CasualCanadian/jareds/Schedule/J.A.R.E.D.S Timeline.pdf

J.A.R.E.D.S Timeline | May 14, 2021 http://
Project manager | Gabriel Carey
Project dates | May 17, 2021 - Jun. 21, 2021
Completion | 0%
Tasks | 14
Resources | 1

Scheduled tasks for J.A.R.E.D.S.

Name | Begin date | End date
3D Printing Design/3D Print any necessary parts for functionality/ergonomics/aesthetics. | 2021-05-17 | 2021-06-04
Gun Hardware Modify Nerf gun, implement new hardware components and schematic. | 2021-05-17 | 2021-05-21
Gun Hardware Complete | 2021-05-24 | 2021-05-24
Structure Gun Firmware Program Arduino for basic functionality, debug system. Begin structuing code for later. | 2021-05-20 | 2021-05-25
Frame Construct frame, test servos. | 2021-05-24 | 2021-05-28
Structure Frame Firmware Program Arduino for basic functionality, debug system. Begin structuing code for later. Tune servos for movement. | 2021-05-26 | 2021-06-01
Frame Complete | 2021-05-31 | 2021-05-31
Gun Firmware Finish coding firmware for Nerf gun. Add functionality to all components and debug code. | 2021-06-02 | 2021-06-04
Gun Firmware Complete | 2021-06-07 | 2021-06-07
Develop Bluetooth Application Develop PC Bluetooth application for remote control of the sentry gun. | 2021-06-07 | 2021-06-11
Software Develop auto-targeting software on Raspberry Pi using Python. Implement serial communication between Raspberry Pi and Arduino. Program interface for Arduino to communicate with Raspberry Pi, receive data and control servos. | 2021-06-07 | 2021-06-16
Complete Software | 2021-06-17 | 2021-06-17
Testing/Debugging Final testing/debugging for reliable operation. | 2021-06-14 | 2021-06-18
Complete Project | 2021-06-21 | 2021-06-21
J.A.R.E.D.S Timeline | May 14, 2021
Tasks | 2

Name | Default role
Gabriel Carey | project manager

# Resources

3

# Gantt Chart

4

Structure Gun Firmware | 2021-05-20 | 2021-05-25
Frame | 2021-05-24 | 2021-05-28
Structure Frame Firmware | 2021-05-26 | 2021-06-01
Frame Complete | 2021-05-31 | 2021-05-31
Gun Firmware | 2021-06-02 | 2021-06-04
Gun Firmware Complete | 2021-06-07 | 2021-06-07
Develop Bluetooth Application 2021-06-07 | 2021-06-11
Software | 2021-06-07 | 2021-06-16
Complete Software | 2021-06-17 | 2021-06-17
Testing/Debugging | 2021-06-14 | 2021-06-18
Complete Project | 2021-06-21 | 2021-06-21

# Resources Chart

5
