CasualCanadian/jareds/Schedule/J.A.R.E.D.S Timeline.png

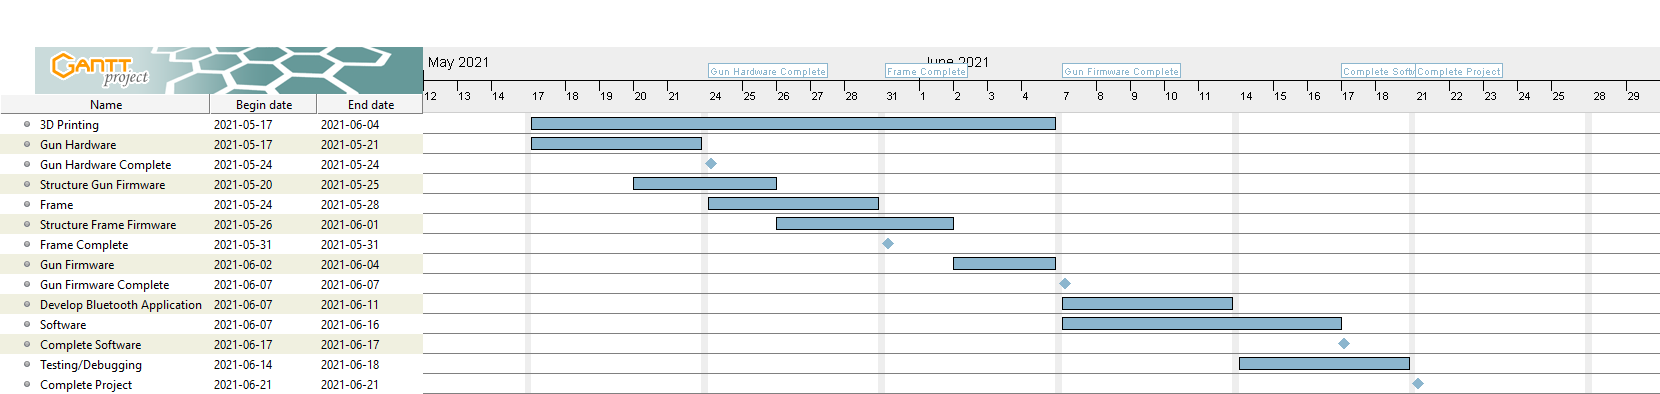
Schedule/J.A.R.E.D.S Timeline.png
