CasualCanadian/jareds/Schematics/J.A.R.E.D.S_Gun_schem.png

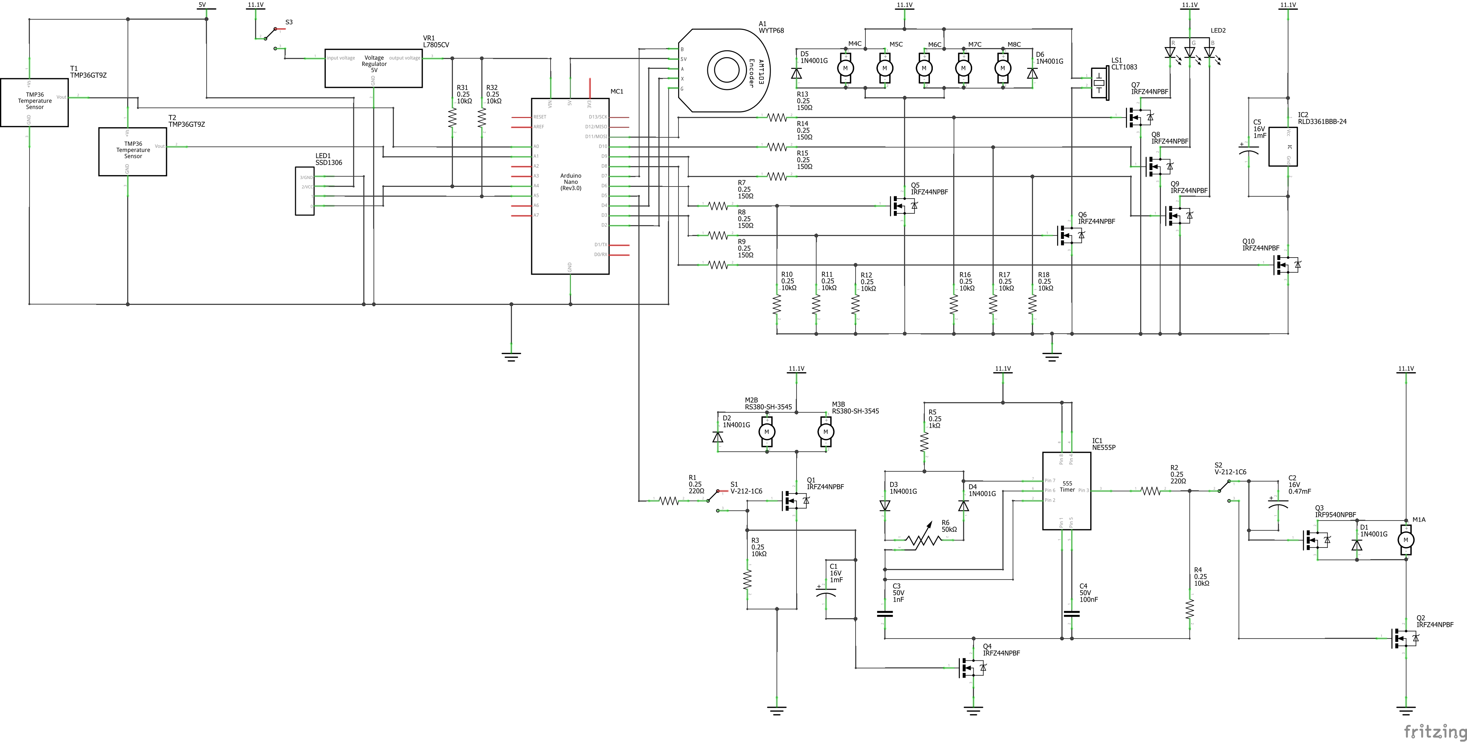
Schematics/J.A.R.E.D.S_Gun_schem.png
