CasualCanadian/jareds/3D Models/Rear_Assembly.stl

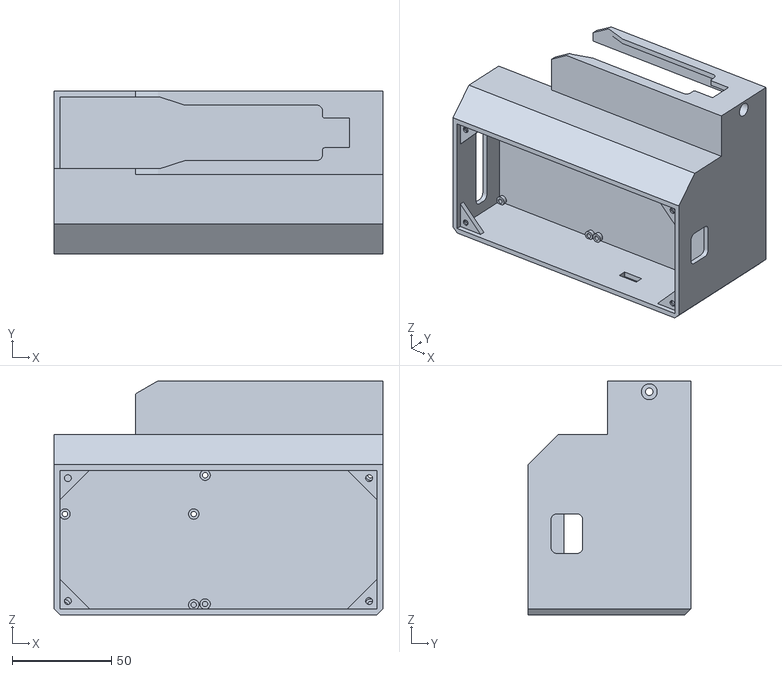
[picture p13: CAD file, 2023-03-03]
3D Models/Rear_Assembly.stl
166.0 x 82.0 x 118.0
