CasualCanadian/jareds/3D Models/Bearing Frame.stl

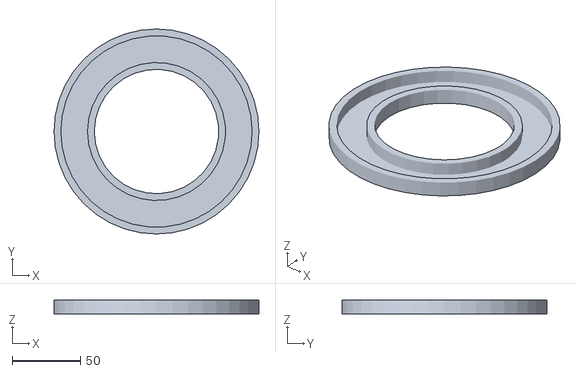
[picture p14: CAD file, 2023-03-03]
3D Models/Bearing Frame.stl
150.0 x 150.0 x 10.0
