CasualCanadian/jareds/3D Models/Frame Model v1/Base_BottomPlate.stl

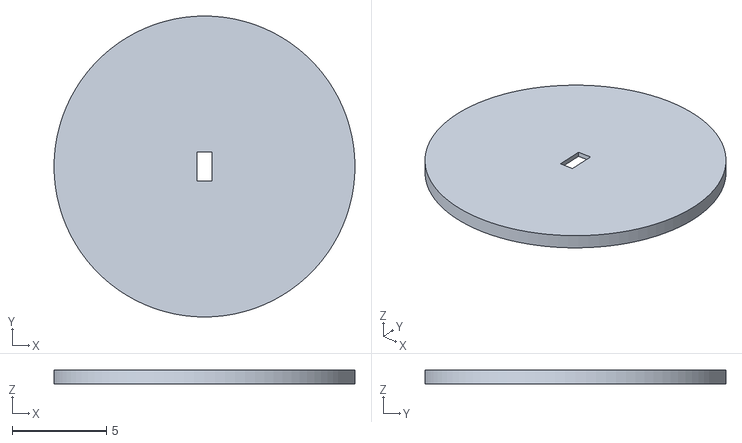
[picture p15: CAD file, 2023-03-03]
3D Models/Frame Model v1/Base_BottomPlate.stl
16.0 x 16.0 x 0.75
