CasualCanadian/jareds/3D Models/Frame Model v1/Arm_Upper.stl

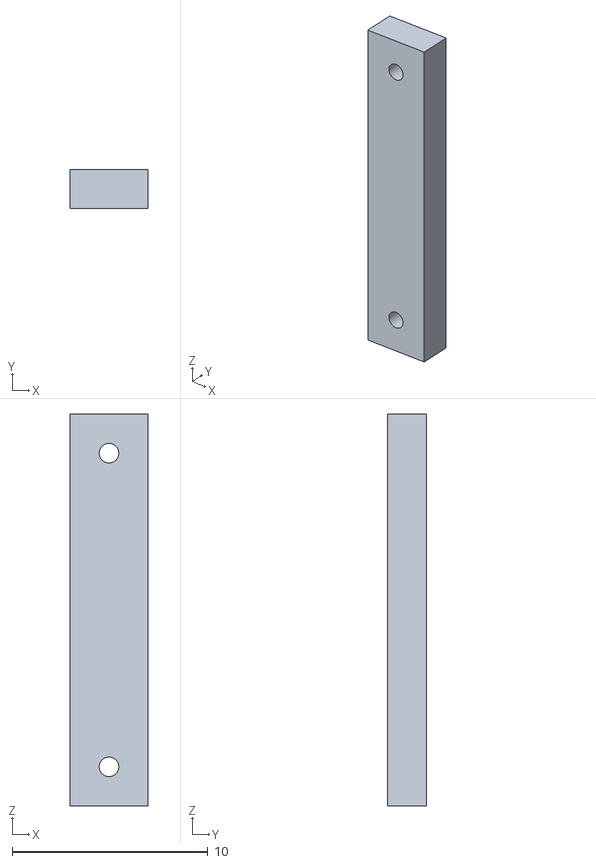
[picture p16: CAD file, 2023-03-03]
3D Models/Frame Model v1/Arm_Upper.stl
4.00 x 2.00 x 20.0
