CasualCanadian/jareds/3D Models/Frame Model v1/Base_Leg.stl

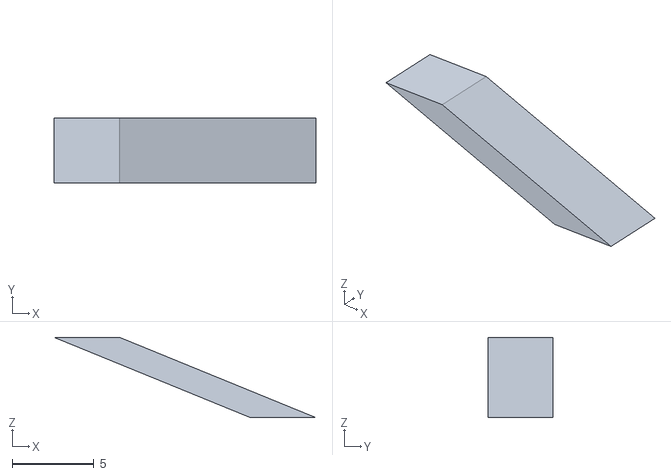
[picture p17: CAD file, 2023-03-03]
3D Models/Frame Model v1/Base_Leg.stl
16.0 x 4.00 x 4.91
