CasualCanadian/jareds/3D Models/Edge Bearing.stl

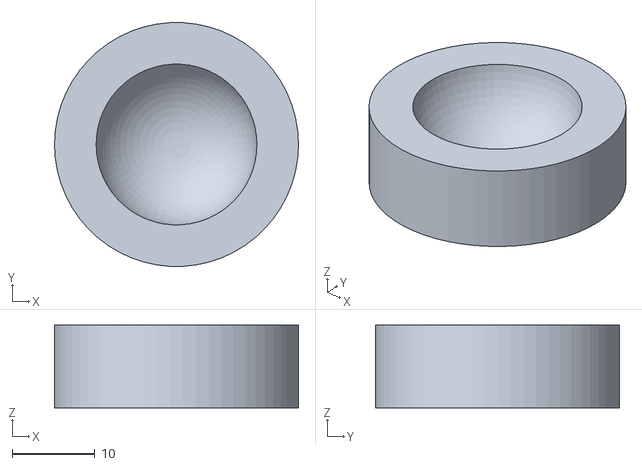
[picture p18: CAD file, 2023-03-03]
3D Models/Edge Bearing.stl
29.5 x 29.5 x 10.0
