CasualCanadian/jareds/3D Models/Frame Model v1/Dowel 2.stl

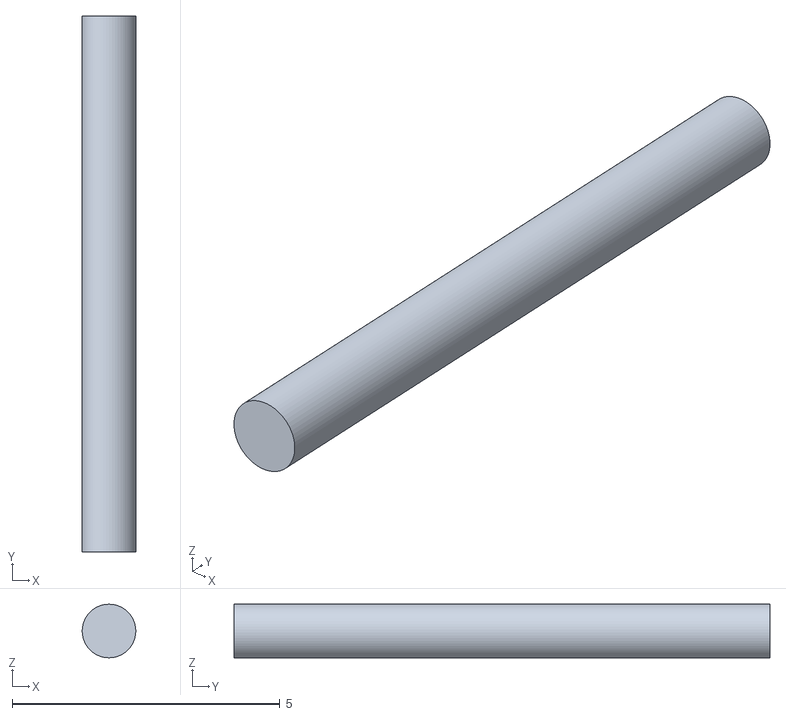
[picture p19: CAD file, 2023-03-03]
3D Models/Frame Model v1/Dowel 2.stl
0.999 x 10.0 x 1
