CasualCanadian/jareds/3D Models/Frame Model v1/Arm_ConnectorLeft.stl

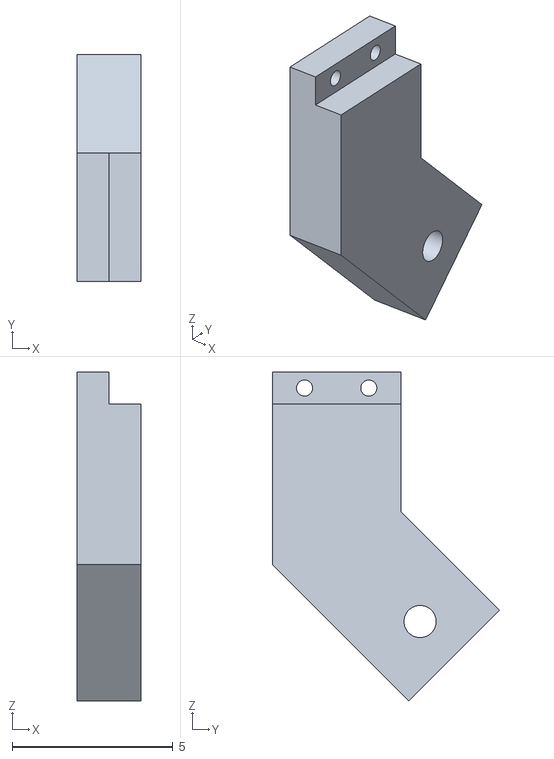
[picture p20: CAD file, 2023-03-03]
3D Models/Frame Model v1/Arm_ConnectorLeft.stl
2.00 x 7.07 x 10.2
