CasualCanadian/jareds/3D Models/Frame Model v1/Base_TopPlate.stl

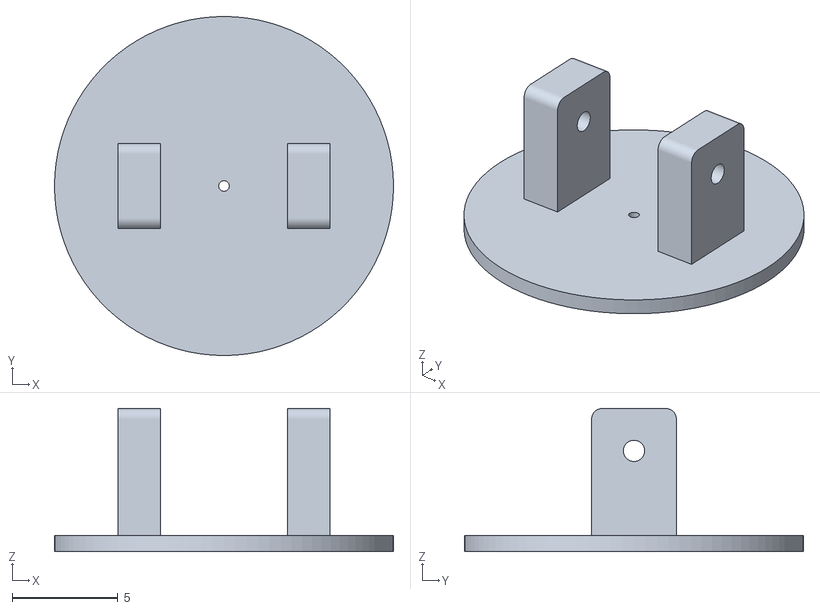
[picture p21: CAD file, 2023-03-03]
3D Models/Frame Model v1/Base_TopPlate.stl
16.0 x 16.0 x 6.75
