CasualCanadian/jareds/3D Models/Handle_Left.stl

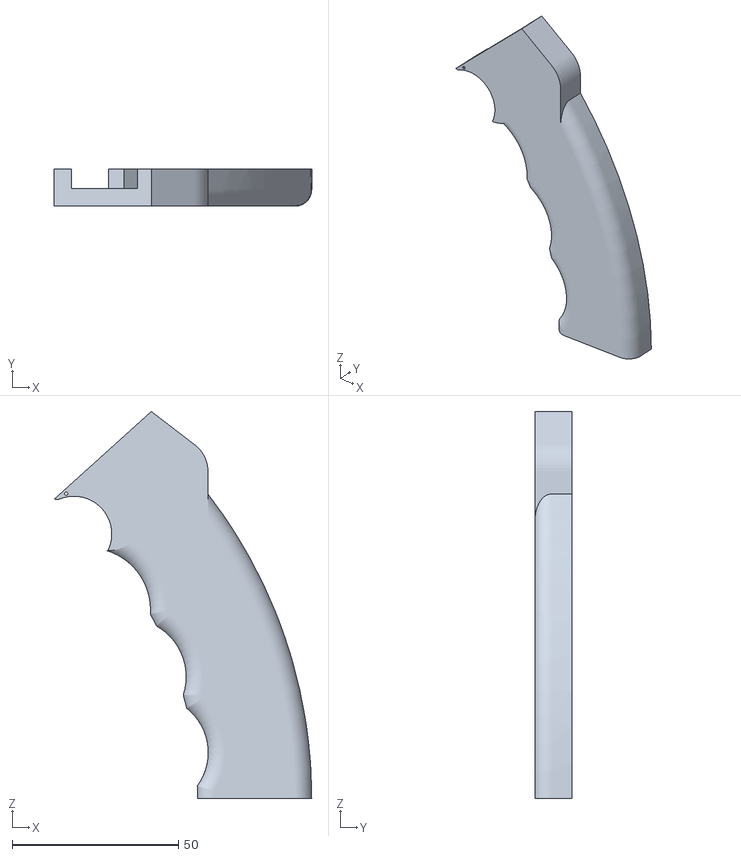
[picture p22: CAD file, 2023-03-03]
3D Models/Handle_Left.stl
77.5 x 11.3 x 116.4
