CasualCanadian/jareds/3D Models/Frame Model v1/Dowel 1.stl

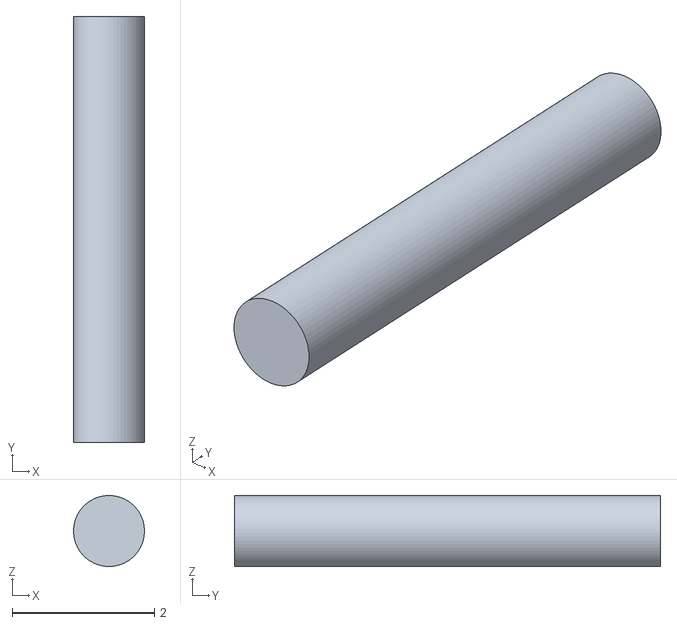
[picture p23: CAD file, 2023-03-03]
3D Models/Frame Model v1/Dowel 1.stl
0.999 x 6.00 x 1
