CasualCanadian/jareds/3D Models/Bearing.stl

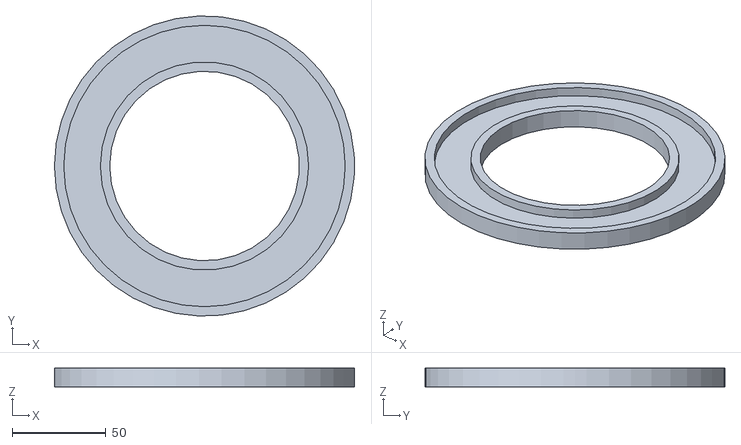
[picture p24: CAD file, 2023-03-03]
3D Models/Bearing.stl
160.0 x 159.9 x 10.0
