CasualCanadian/jareds/3D Models/Frame Model v1/Base_Leg 2.stl

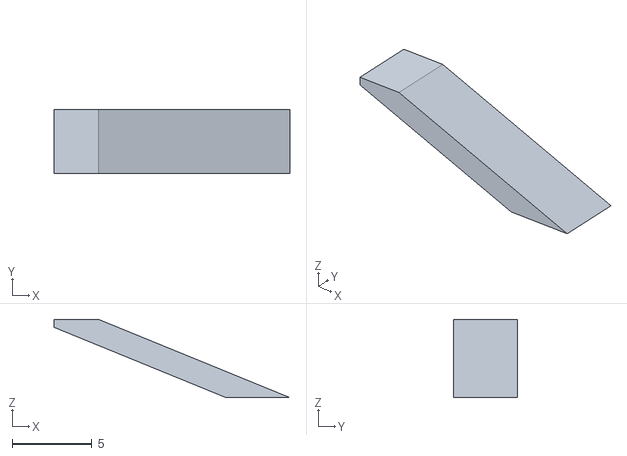
[picture p25: CAD file, 2023-03-03]
3D Models/Frame Model v1/Base_Leg 2.stl
14.8 x 4.00 x 4.91
