CasualCanadian/jareds/3D Models/Frame Model v1/Base_Adapter.stl

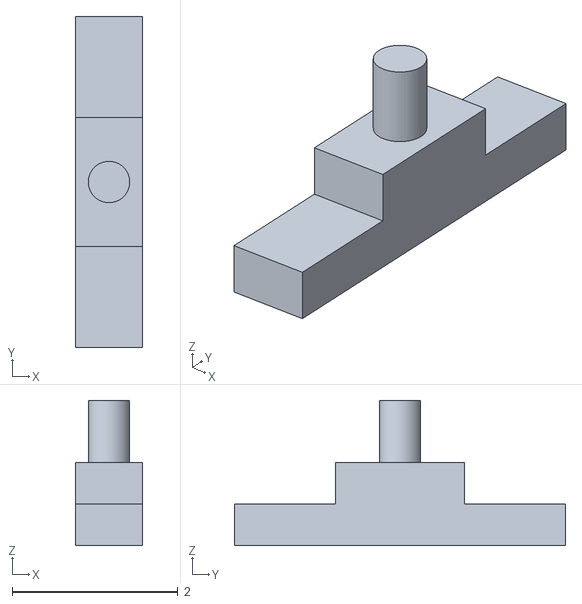
[picture p26: CAD file, 2023-03-03]
3D Models/Frame Model v1/Base_Adapter.stl
0.81 x 4.00 x 1.75
