CasualCanadian/jareds/3D Models/Motor Housing.stl

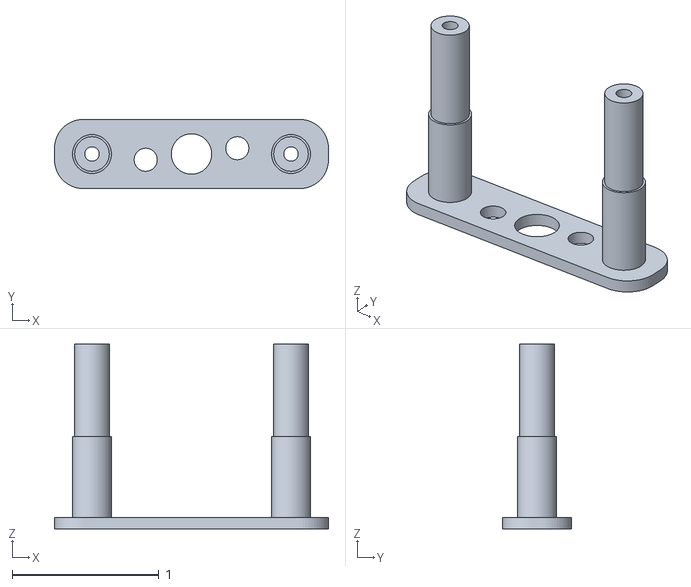
[picture p27: CAD file, 2023-03-03]
3D Models/Motor Housing.stl
1.87 x 0.472 x 1.26
