CasualCanadian/jareds/3D Models/BearingFramev2.stl

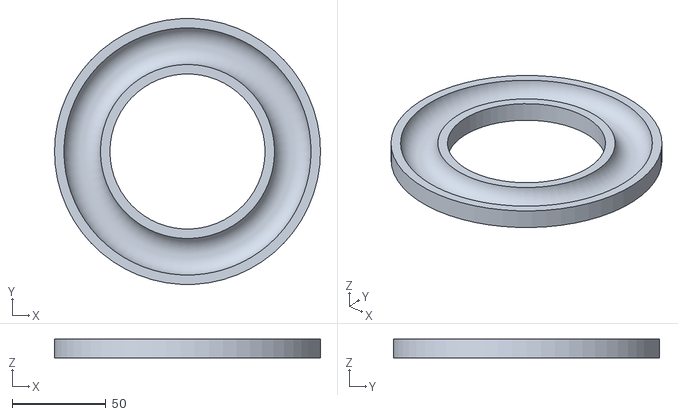
[picture p28: CAD file, 2023-03-03]
3D Models/BearingFramev2.stl
141.5 x 141.3 x 10.0
