CasualCanadian/jareds/3D Models/Rear Mount.stl

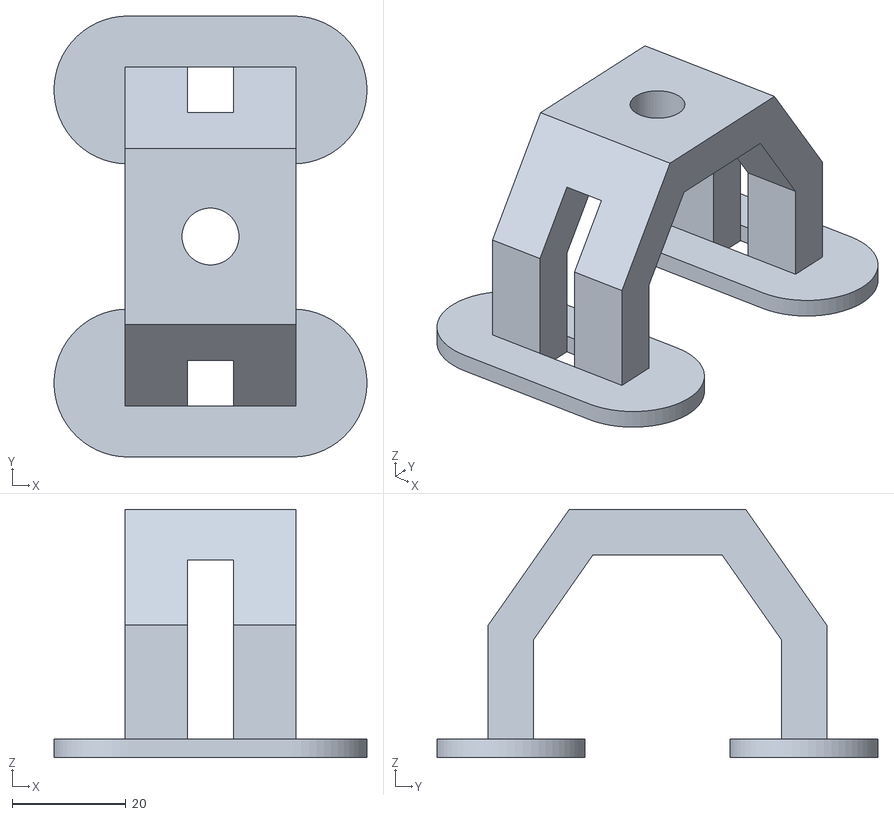
[picture p30: CAD file, 2023-03-03]
3D Models/Rear Mount.stl
55.0 x 77.5 x 43.7
