CasualCanadian/jareds/3D Models/J.A.R.E.D.S Name Plate.stl

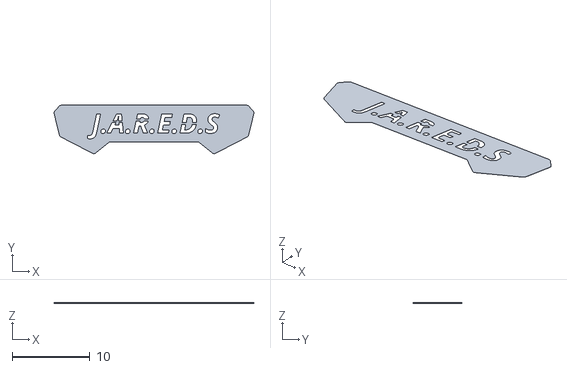
[picture p31: CAD file, 2023-03-03]
3D Models/J.A.R.E.D.S Name Plate.stl
25.7 x 6.24 x 0.08
