CasualCanadian/jareds/3D Models/Front Mount.stl

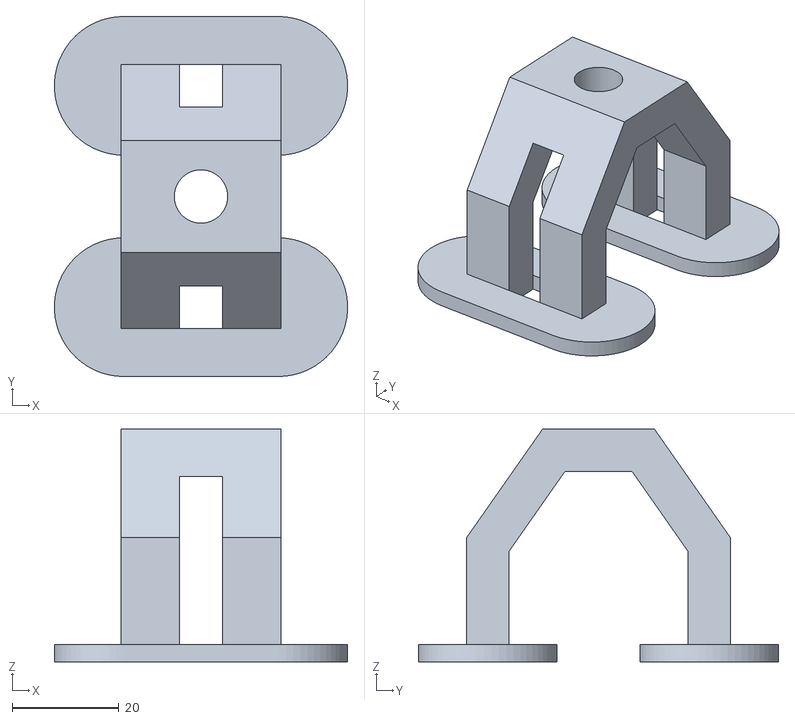
[picture p32: CAD file, 2023-03-03]
3D Models/Front Mount.stl
55.0 x 67.5 x 43.7
