CasualCanadian/jareds/3D Models/Trigger.stl

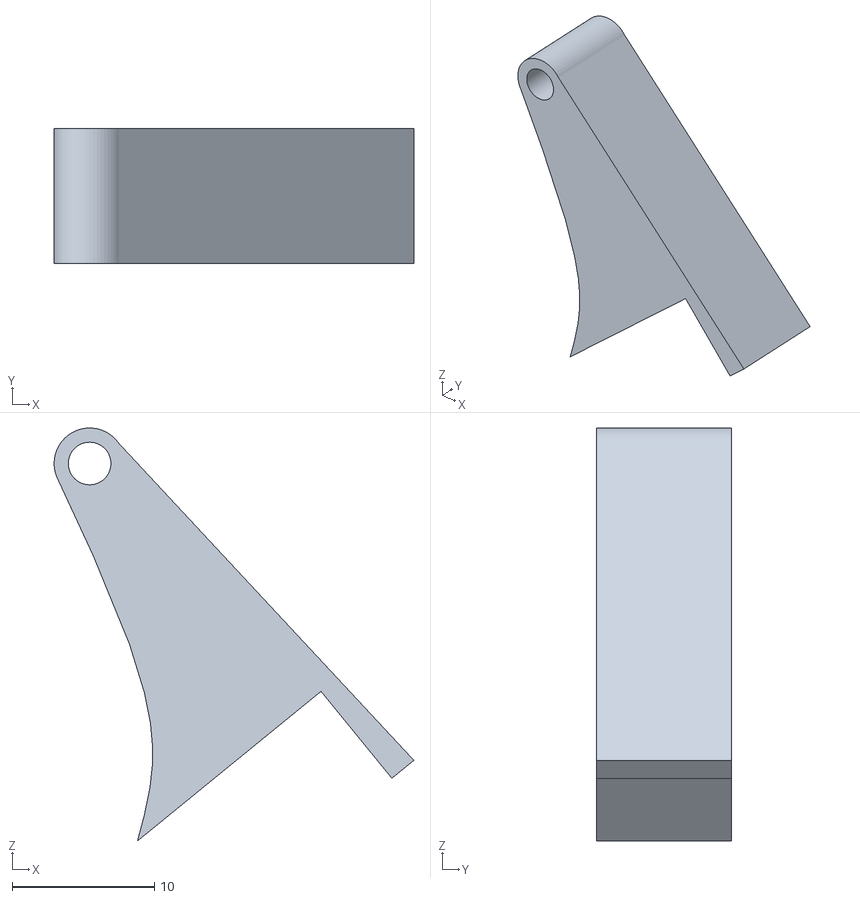
[picture p33: CAD file, 2023-03-03]
3D Models/Trigger.stl
25.3 x 9.50 x 29.1
