CasualCanadian/jareds/3D Models/Trigger_LongLever.stl

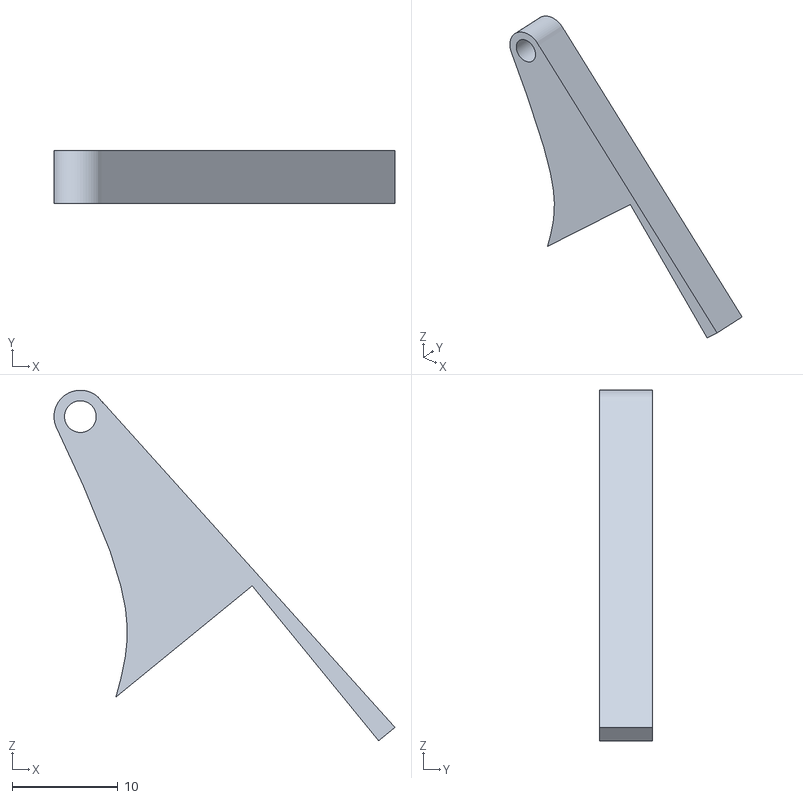
[picture p34: CAD file, 2023-03-03]
3D Models/Trigger_LongLever.stl
32.3 x 5.00 x 33.2
