CasualCanadian/jareds/3D Models/J.A.R.E.D.S_Stencilv2.stl

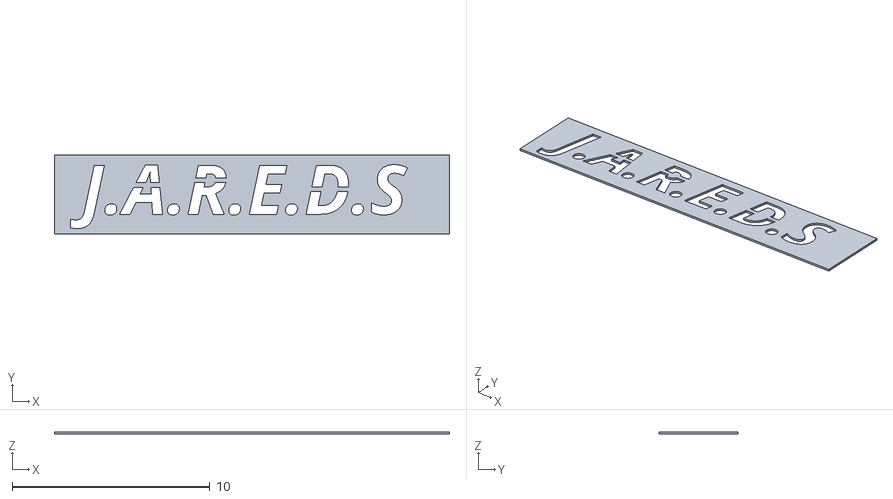
[picture p35: CAD file, 2023-03-03]
3D Models/J.A.R.E.D.S_Stencilv2.stl
20.0 x 4.00 x 0.1
