CasualCanadian/jareds/3D Models/JAREDS Template.stl

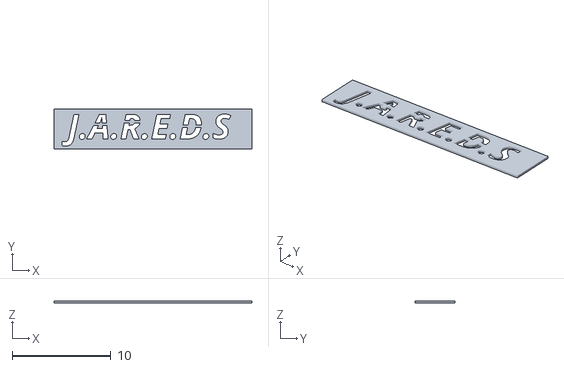
[picture p36: CAD file, 2023-03-03]
3D Models/JAREDS Template.stl
20.0 x 4.00 x 0.2
