CasualCanadian/jareds/3D Models/Bearing_Top.stl

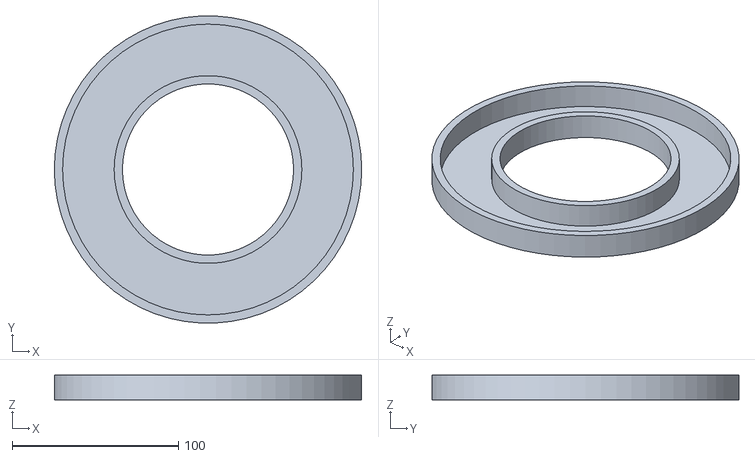
[picture p37: CAD file, 2023-03-03]
3D Models/Bearing_Top.stl
185.0 x 184.7 x 15.0
