CasualCanadian/jareds/3D Models/Handle_Right - Part 3.stl

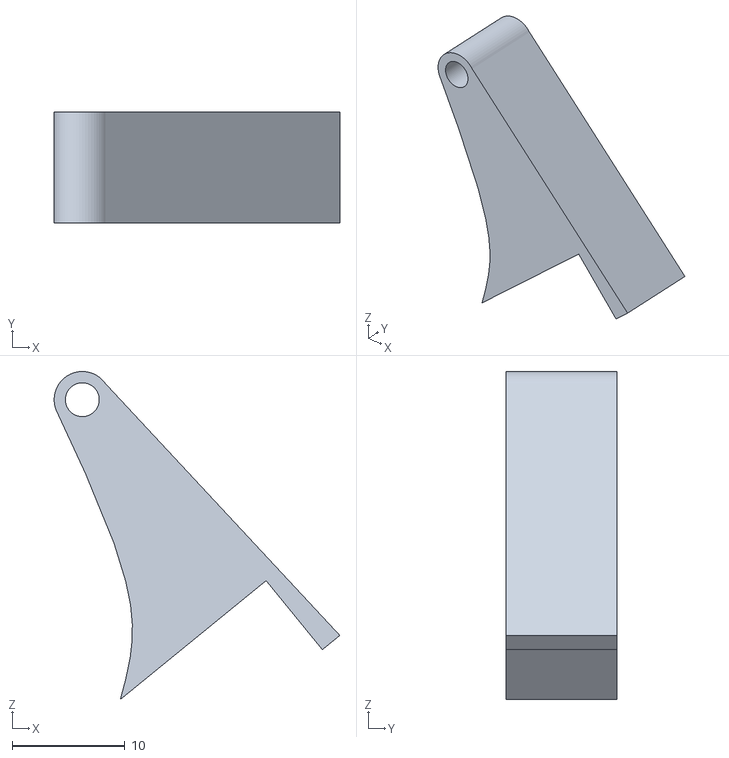
[picture p38: CAD file, 2023-03-03]
3D Models/Handle_Right - Part 3.stl
25.3 x 9.80 x 29.1
