CasualCanadian/jareds/3D Models/Grip_Right.stl

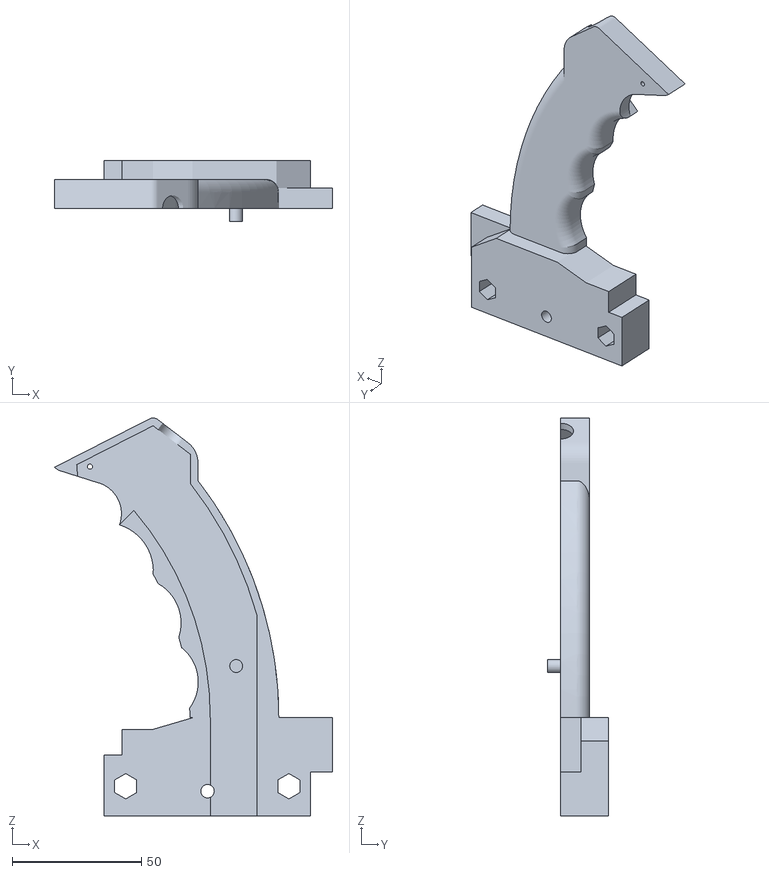
[picture p39: CAD file, 2023-03-03]
3D Models/Grip_Right.stl
107.7 x 23.5 x 153.9
