CasualCanadian/jareds/3D Models/Camera_FrontMount.stl

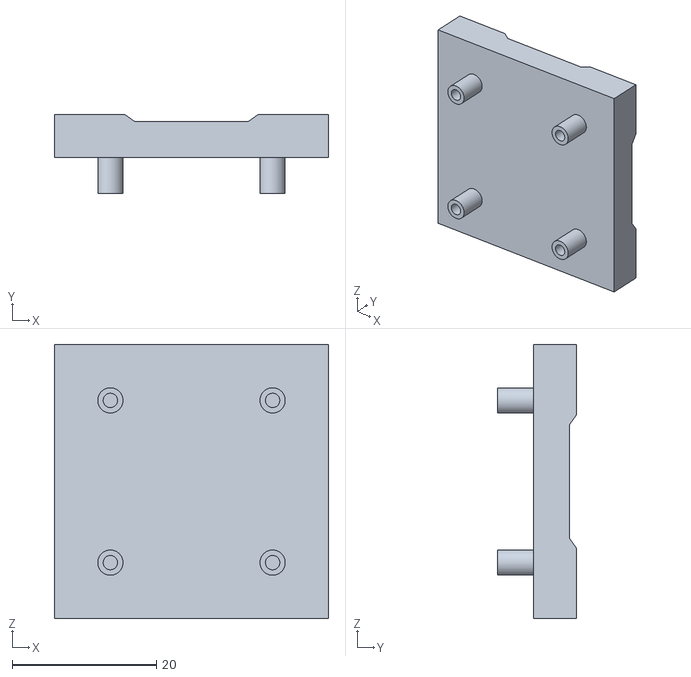
[picture p40: CAD file, 2023-03-03]
3D Models/Camera_FrontMount.stl
38.0 x 11.0 x 38.0
