CasualCanadian/jareds/3D Models/Arm_BasePlate.stl

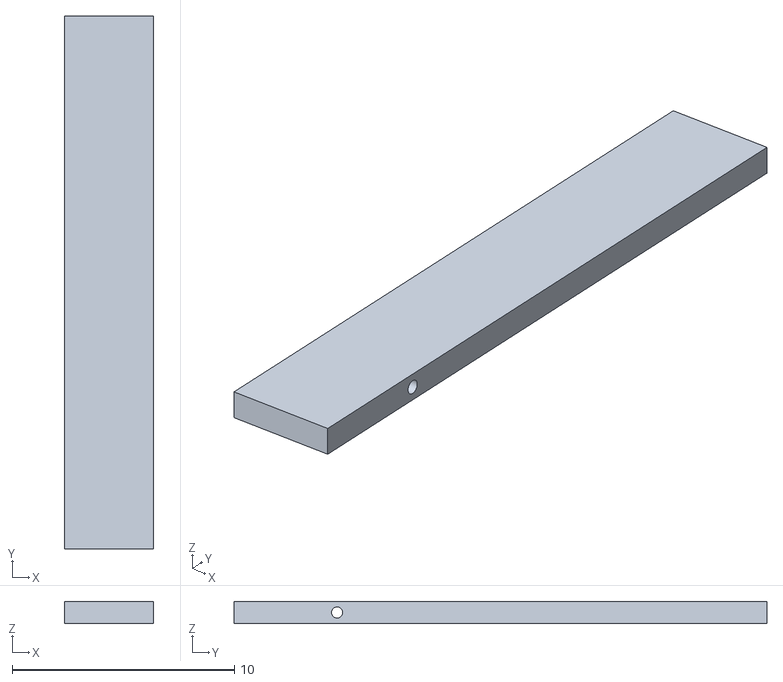
[picture p41: CAD file, 2023-03-03]
3D Models/Arm_BasePlate.stl
4.00 x 24.0 x 1.00
