CasualCanadian/jareds/3D Models/Gun Mount.stl

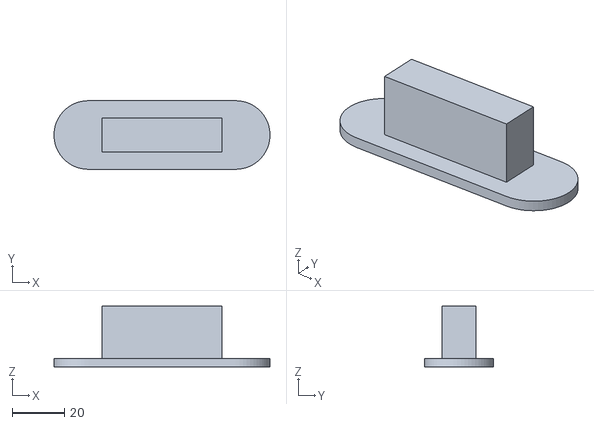
[picture p42: CAD file, 2023-03-03]
3D Models/Gun Mount.stl
82.8 x 26.3 x 23.3
