CasualCanadian/jareds/3D Models/Voltmeter_Spacer.stl

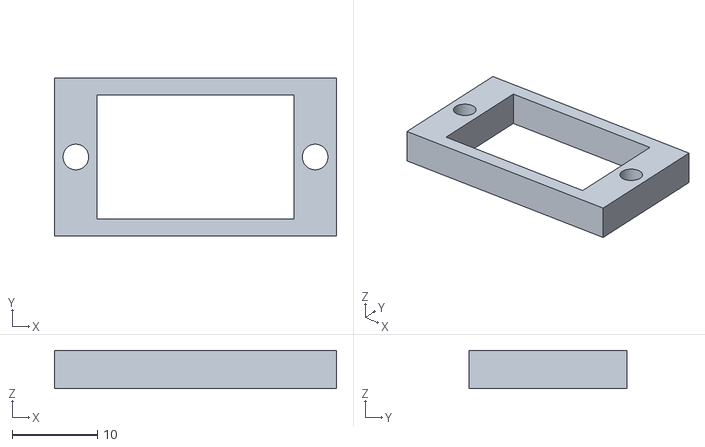
[picture p43: CAD file, 2023-03-03]
3D Models/Voltmeter_Spacer.stl
33.0 x 18.5 x 4.50
