CasualCanadian/jareds/3D Models/Bottom Adapter.stl

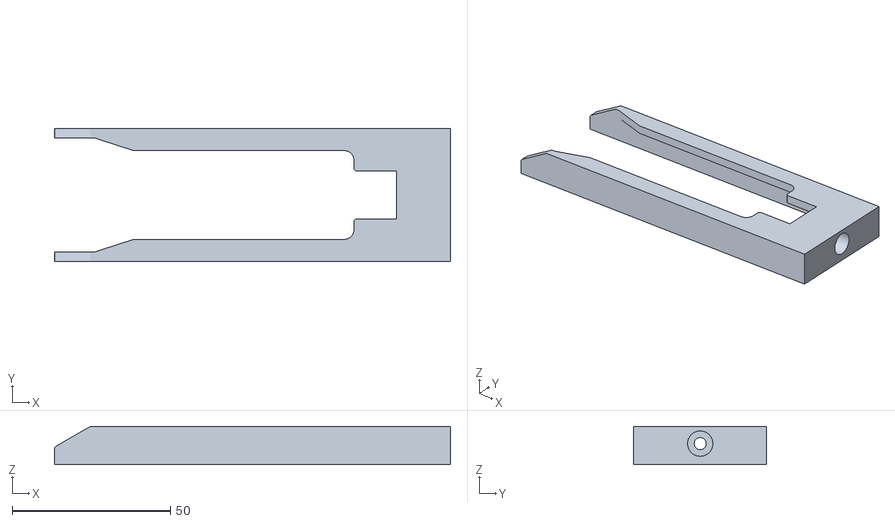
[picture p44: CAD file, 2023-03-03]
3D Models/Bottom Adapter.stl
125.0 x 42.0 x 12.0
