CasualCanadian/jareds/3D Models/J.A.R.E.D.S Handle Adapter.stl

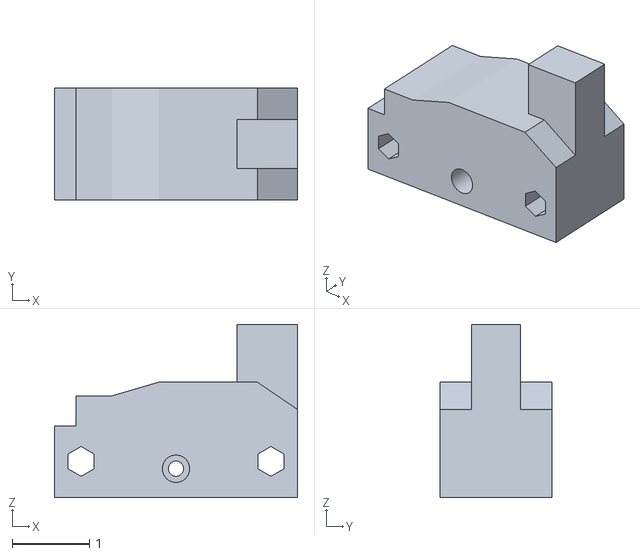
[picture p45: CAD file, 2023-03-03]
3D Models/J.A.R.E.D.S Handle Adapter.stl
3.15 x 1.46 x 2.24
