CasualCanadian/jareds/3D Models/Part Studio 1.stl

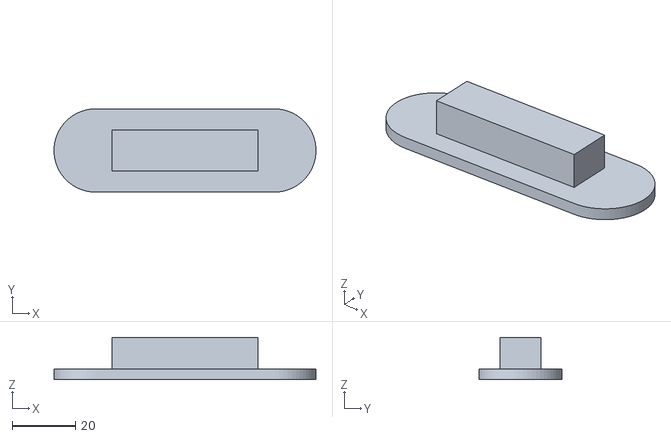
[picture p46: CAD file, 2023-03-03]
3D Models/Part Studio 1.stl
82.8 x 26.3 x 13.3
