CasualCanadian/jareds/3D Models/Rev_Switch.stl

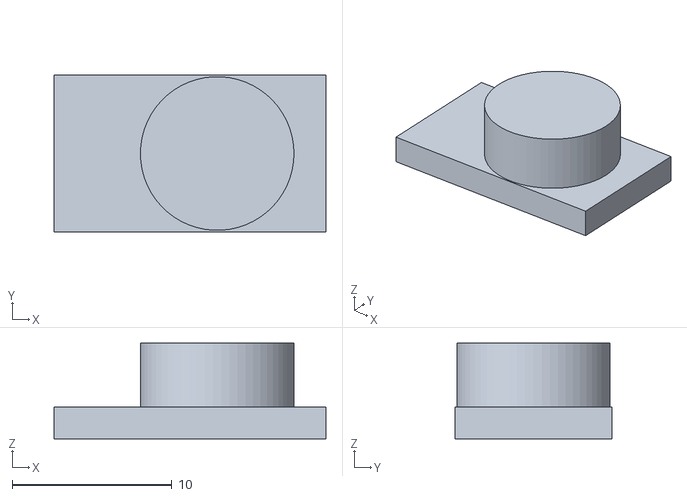
[picture p47: CAD file, 2023-03-03]
3D Models/Rev_Switch.stl
17.0 x 9.80 x 6.00
