CasualCanadian/jareds/3D Models/v1.stl

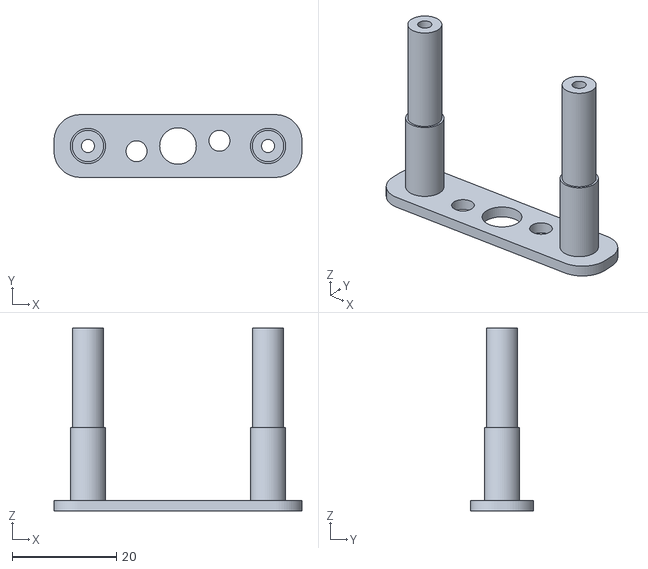
[picture p48: CAD file, 2023-03-03]
3D Models/v1.stl
47.5 x 12.0 x 35.0
