CasualCanadian/jareds/3D Models/Grip_Trigger.stl

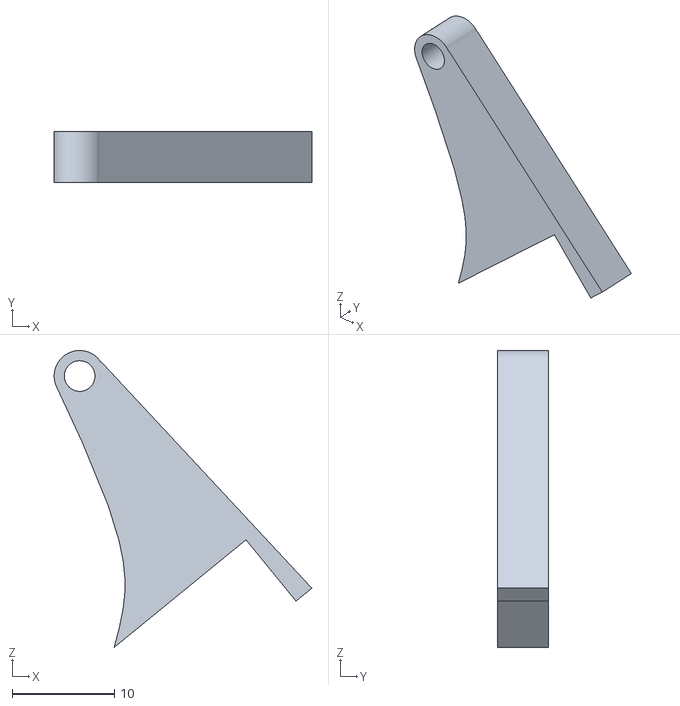
[picture p49: CAD file, 2023-03-03]
3D Models/Grip_Trigger.stl
25.2 x 5.00 x 29.1
