CasualCanadian/jareds/3D Models/gm.stl

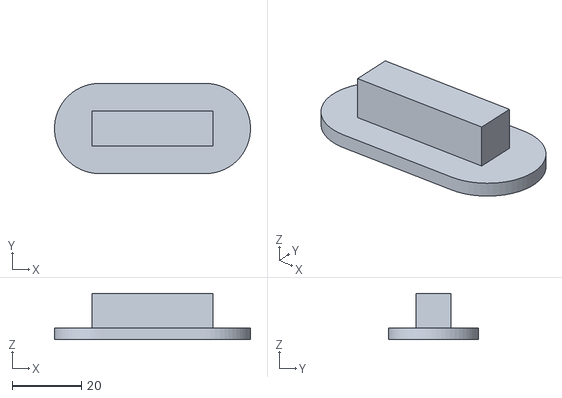
[picture p50: CAD file, 2023-03-03]
3D Models/gm.stl
56.5 x 26.0 x 13.3
