CasualCanadian/jareds/3D Models/J.A.R.E.D.S Template v2.stl

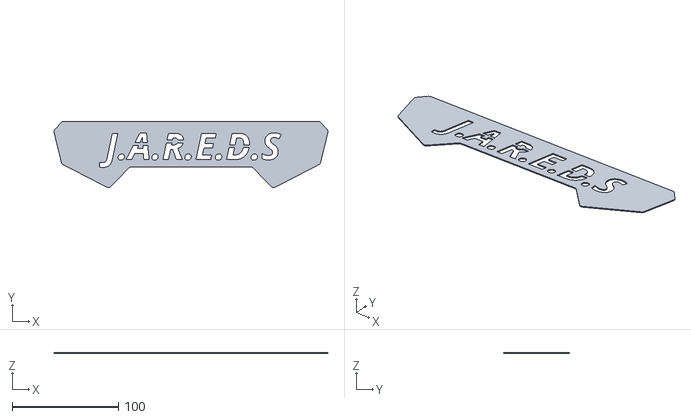
[picture p51: CAD file, 2023-03-03]
3D Models/J.A.R.E.D.S Template v2.stl
257.4 x 62.3 x 0.8
