CasualCanadian/jareds/3D Models/J.A.R.E.D.S Handle Adapter v2.stl

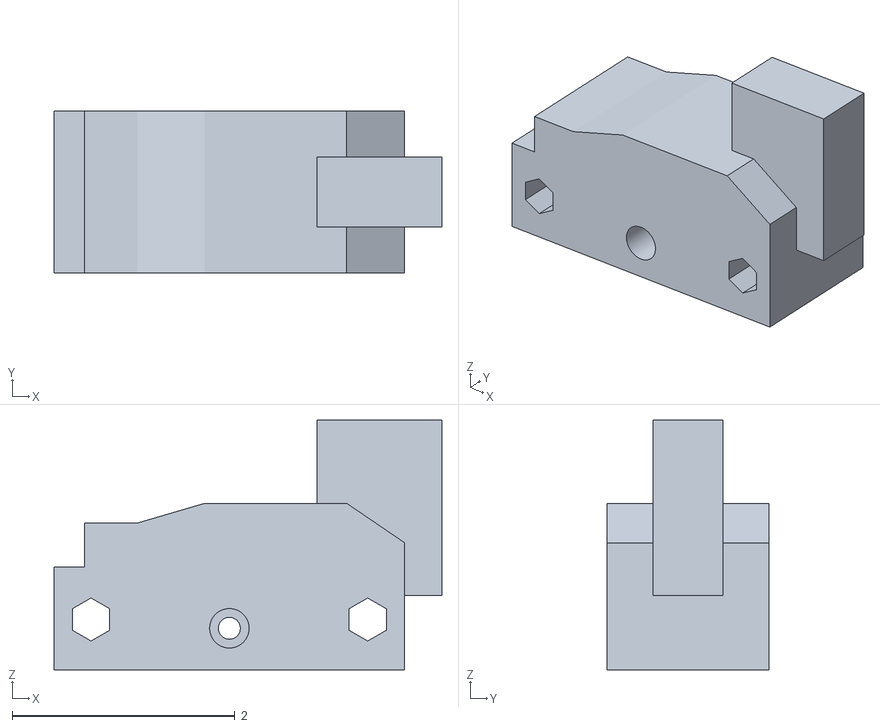
[picture p52: CAD file, 2023-03-03]
3D Models/J.A.R.E.D.S Handle Adapter v2.stl
3.48 x 1.46 x 2.24
