CasualCanadian/jareds/3D Models/Bearing Filling.stl

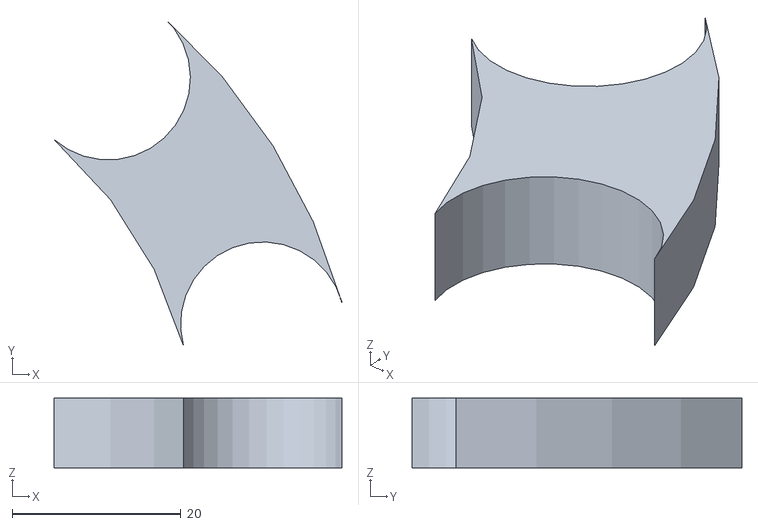
[picture p53: CAD file, 2023-03-03]
3D Models/Bearing Filling.stl
34.2 x 39.2 x 8.25
