CasualCanadian/jareds/3D Models/Grip_Left.stl

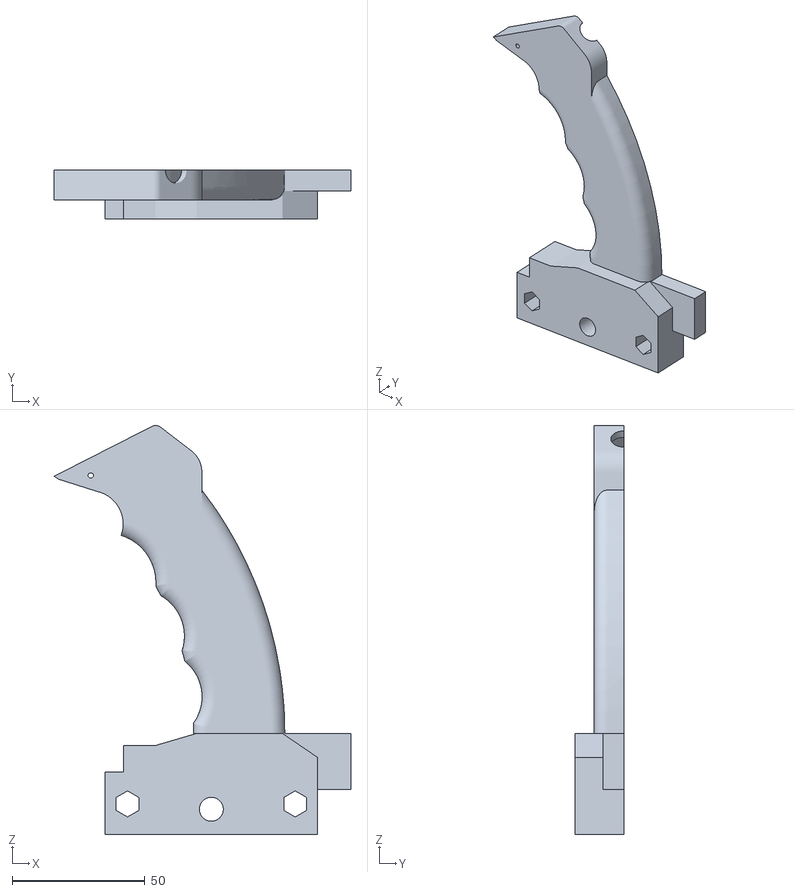
[picture p54: CAD file, 2023-03-03]
3D Models/Grip_Left.stl
111.7 x 18.5 x 153.9
