CasualCanadian/jareds/3D Models/GunMount_Front.stl

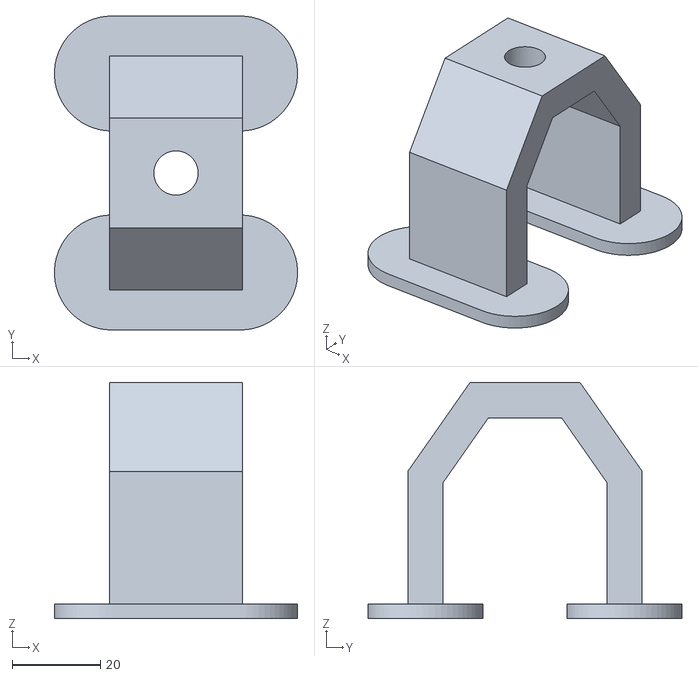
[picture p55: CAD file, 2023-03-03]
3D Models/GunMount_Front.stl
55.0 x 71.0 x 53.4
