CasualCanadian/jareds/(list of files, cad)

Other CAD files:
3D Models/Frame Model v1/Arm_ConnectorRight.stl
3D Models/Bearing_Bottomv3.stl
3D Models/Arm_ConnectorRight.stl
3D Models/Camera_FrontMount (1).stl
3D Models/Camera_FrontMount (2).stl
3D Models/GunMount_Front (1).stl
3D Models/Handle_Left Copy 1 (1).stl
3D Models/Handle_Left Copy 1.stl
3D Models/Handle_Right - Part 3 (1).stl
3D Models/J.A.R.E.D.S Handle Adapter (1).stl
3D Models/Part Studio 1 Copy 1 (1).stl
3D Models/Part Studio 1 Copy 1 (2).stl
3D Models/Part Studio 1 Copy 1.stl
3D Models/Rev_Switch (1).stl
3D Models/Rev_Switch (2).stl
3D Models/Rev_Switch (3).stl
3D Models/v1 (1).stl
