CasualCanadian/jareds/Schematics/J.A.R.E.D.S_BlockDiagram.pdf

/

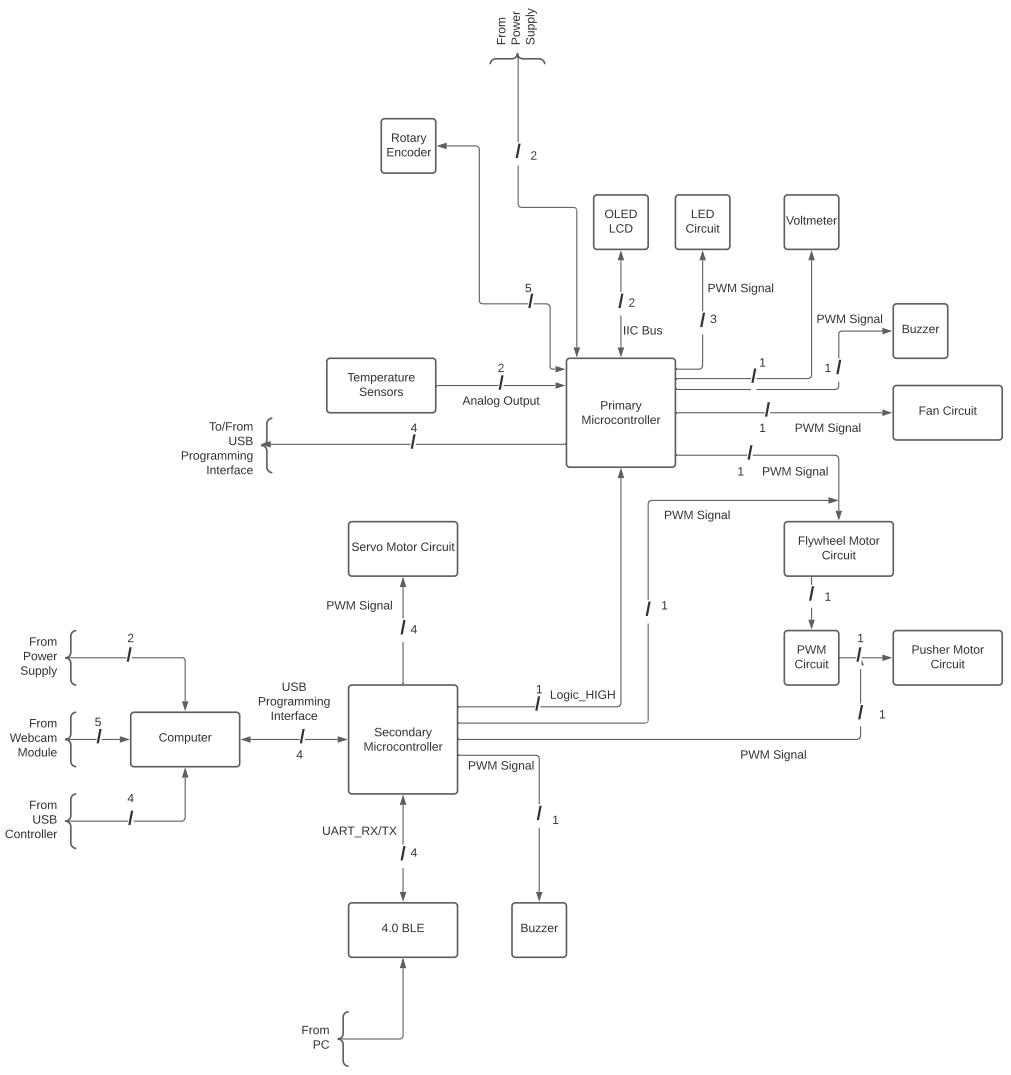
[picture p56: page 1]
Primary Microcontroller; Computer; Secondary; Microcontroller; PWM Circuit; Flywheel Motor Circuit; Pusher Motor Circuit; Fan Circuit; OLED LCD; Temperature Sensors; LED Circuit; From Webcam Module; IIC Bus; 4.0 BLE; Buzzer; Voltmeter; Fro; Sup; ply; From Power Supply; From USB Controller; From PC; USB Programming Interface; UART_RX/TX; PWM Signal; Analog Output; Logic_HIGH; Rotary; Encoder; To/From USB Programming Interface

Servo Motor Circuit
