CasualCanadian/jareds/Schematics/J.A.R.E.D.S_OriginalBlockDiagram.pdf

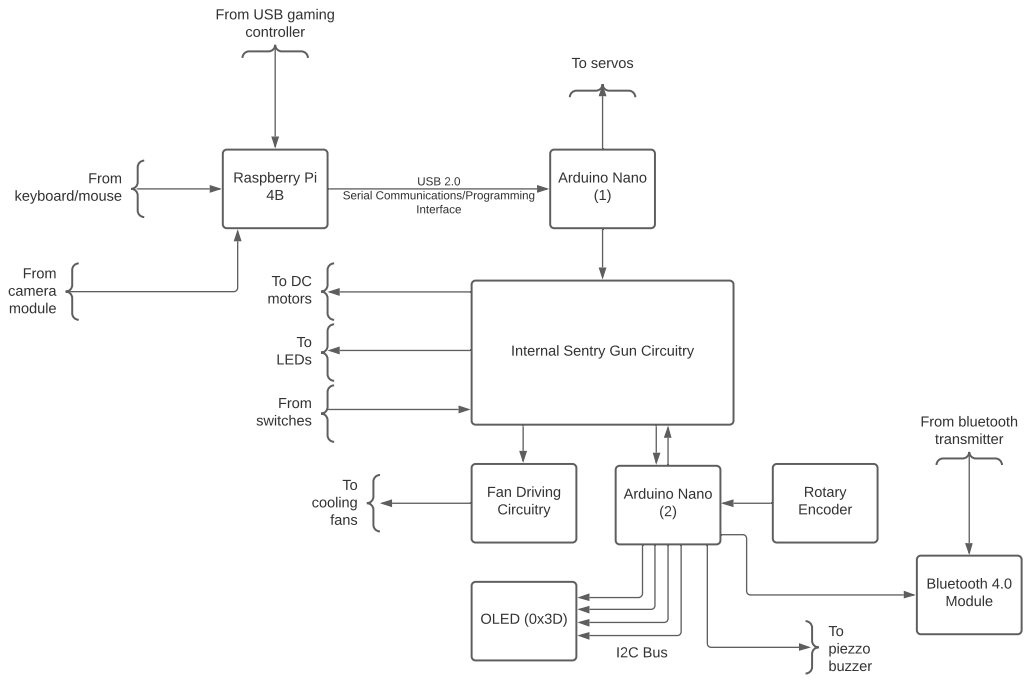
[picture p57: page 1]
Raspberry Pi 4B; Arduino Nano (1); OLED (0x3D); Arduino Nano (2); Rotary Encoder; Fan Driving Circuitry; USB 2.0; Interface; To servos; To DC motors; To LEDs; From switches; To cooling fans; I2C Bus; To piezzo buzzer; Bluetooth 4.0 Module; From camera module; From keyboard/mouse; From bluetooth transmitter

From USB gaming
controller

Serial Communications/Programming

Internal Sentry Gun Circuitry
