CasualCanadian/jareds/Schematics/J.A.R.E.D.S_Frame-Hardware_schem.pdf

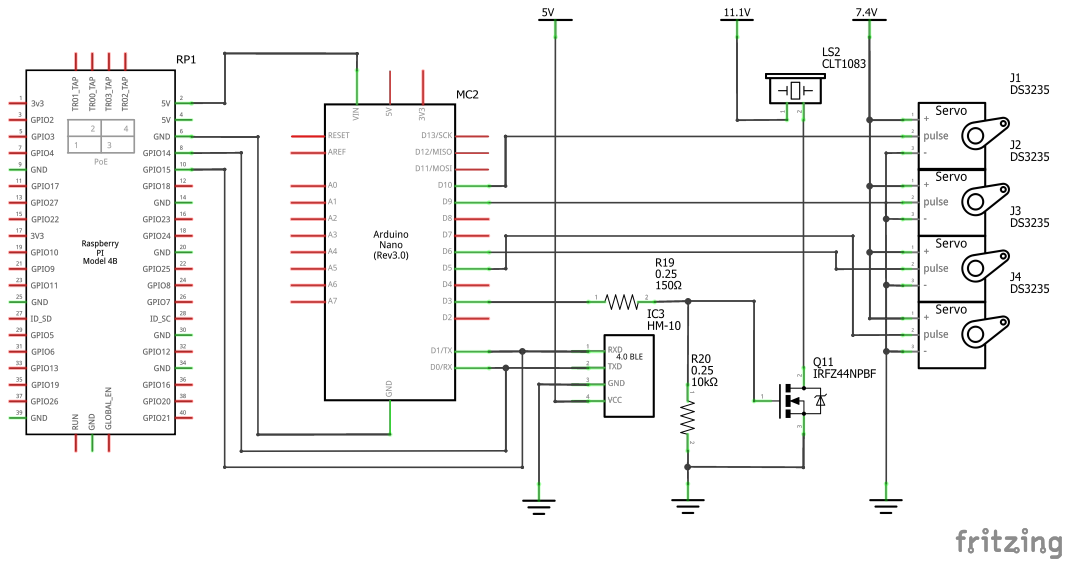
[picture p58: page 1]
