CasualCanadian/jareds/Schematics/J.A.R.E.D.S_Gun_schem.pdf

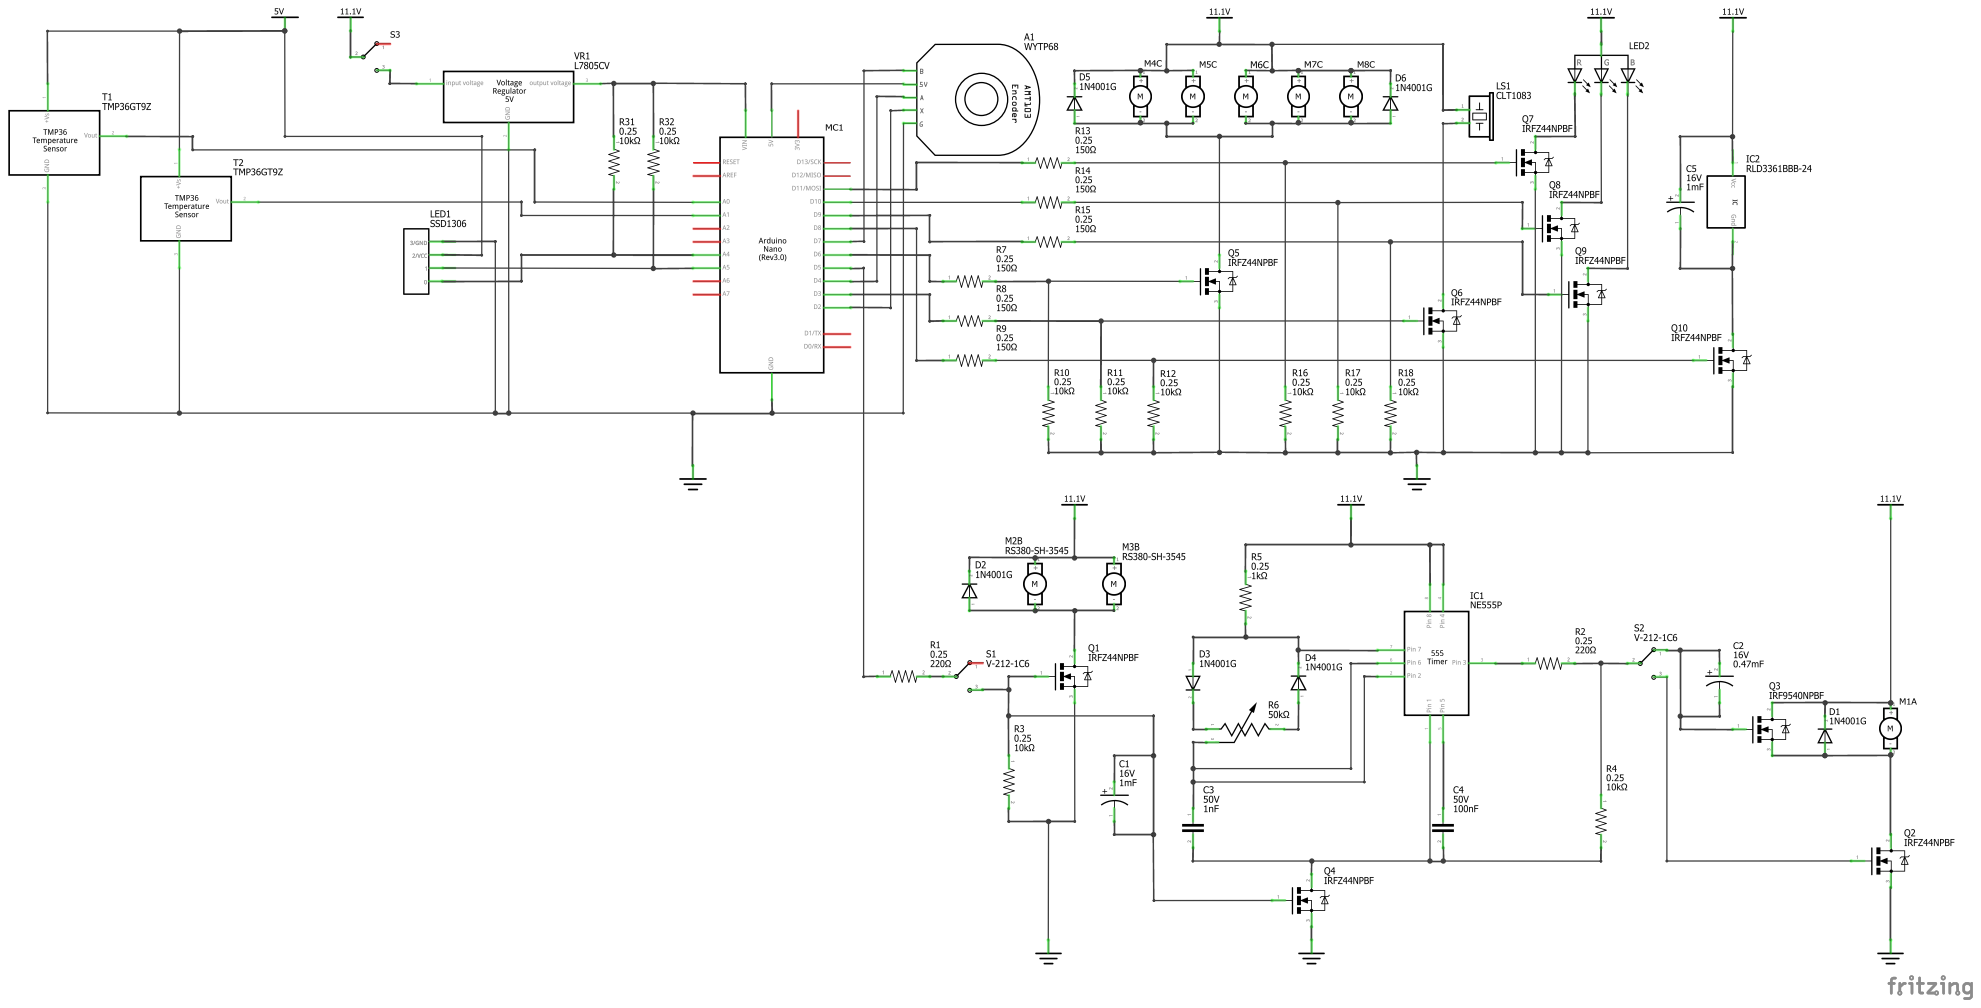
[picture p59: page 1]
