CasualCanadian/jareds/Schematics/J.A.R.E.D.S_Main-Firing-Circuitv1_schem.pdf

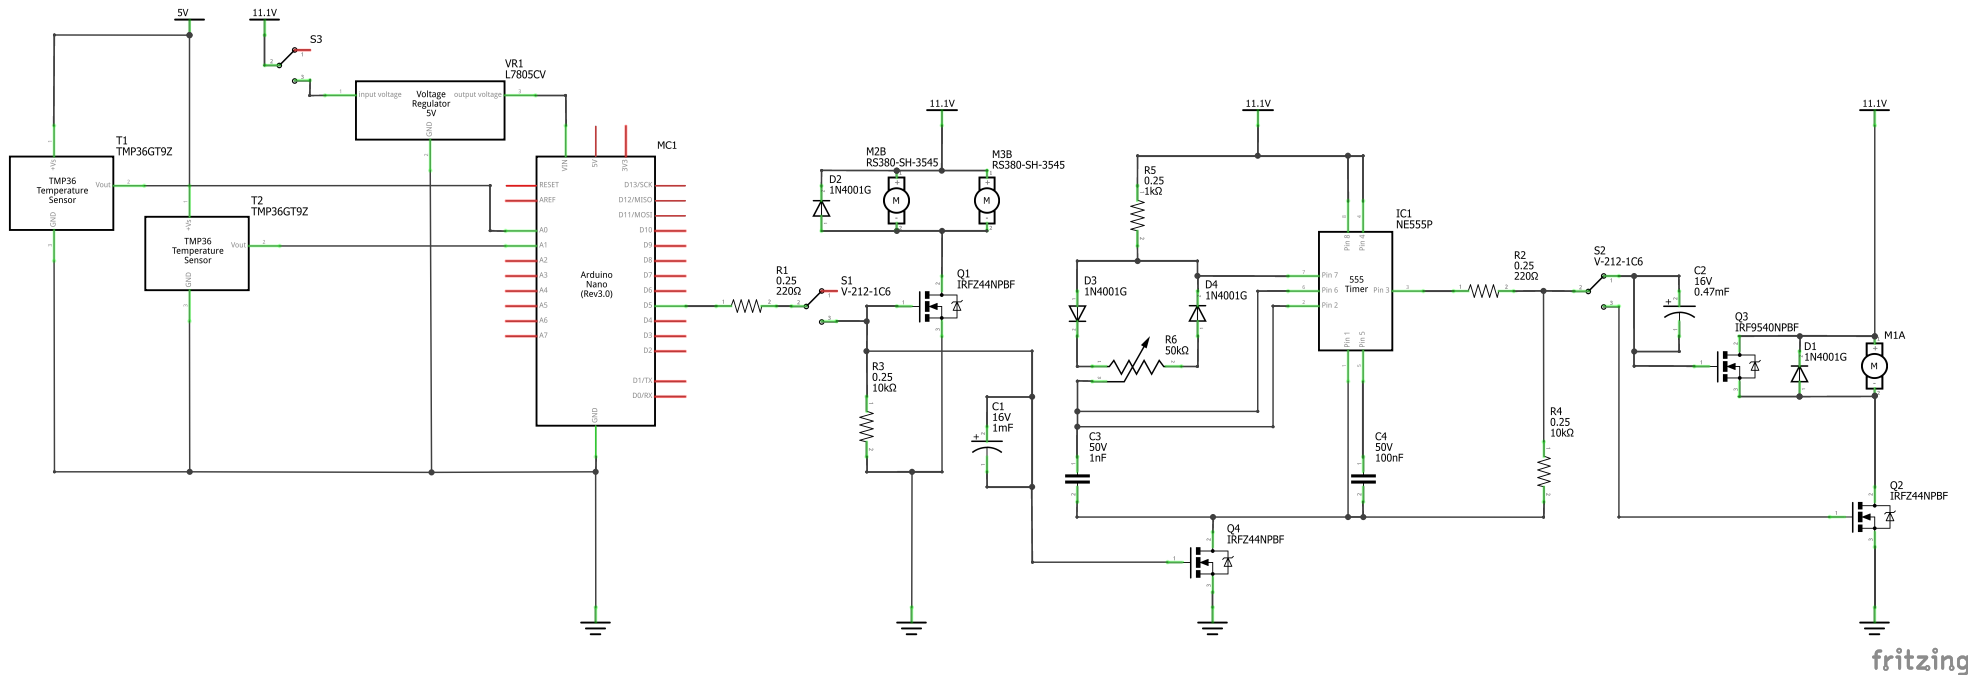
[picture p60: page 1]
