CasualCanadian/jareds/Schematics/J.A.R.E.D.S_schem.pdf

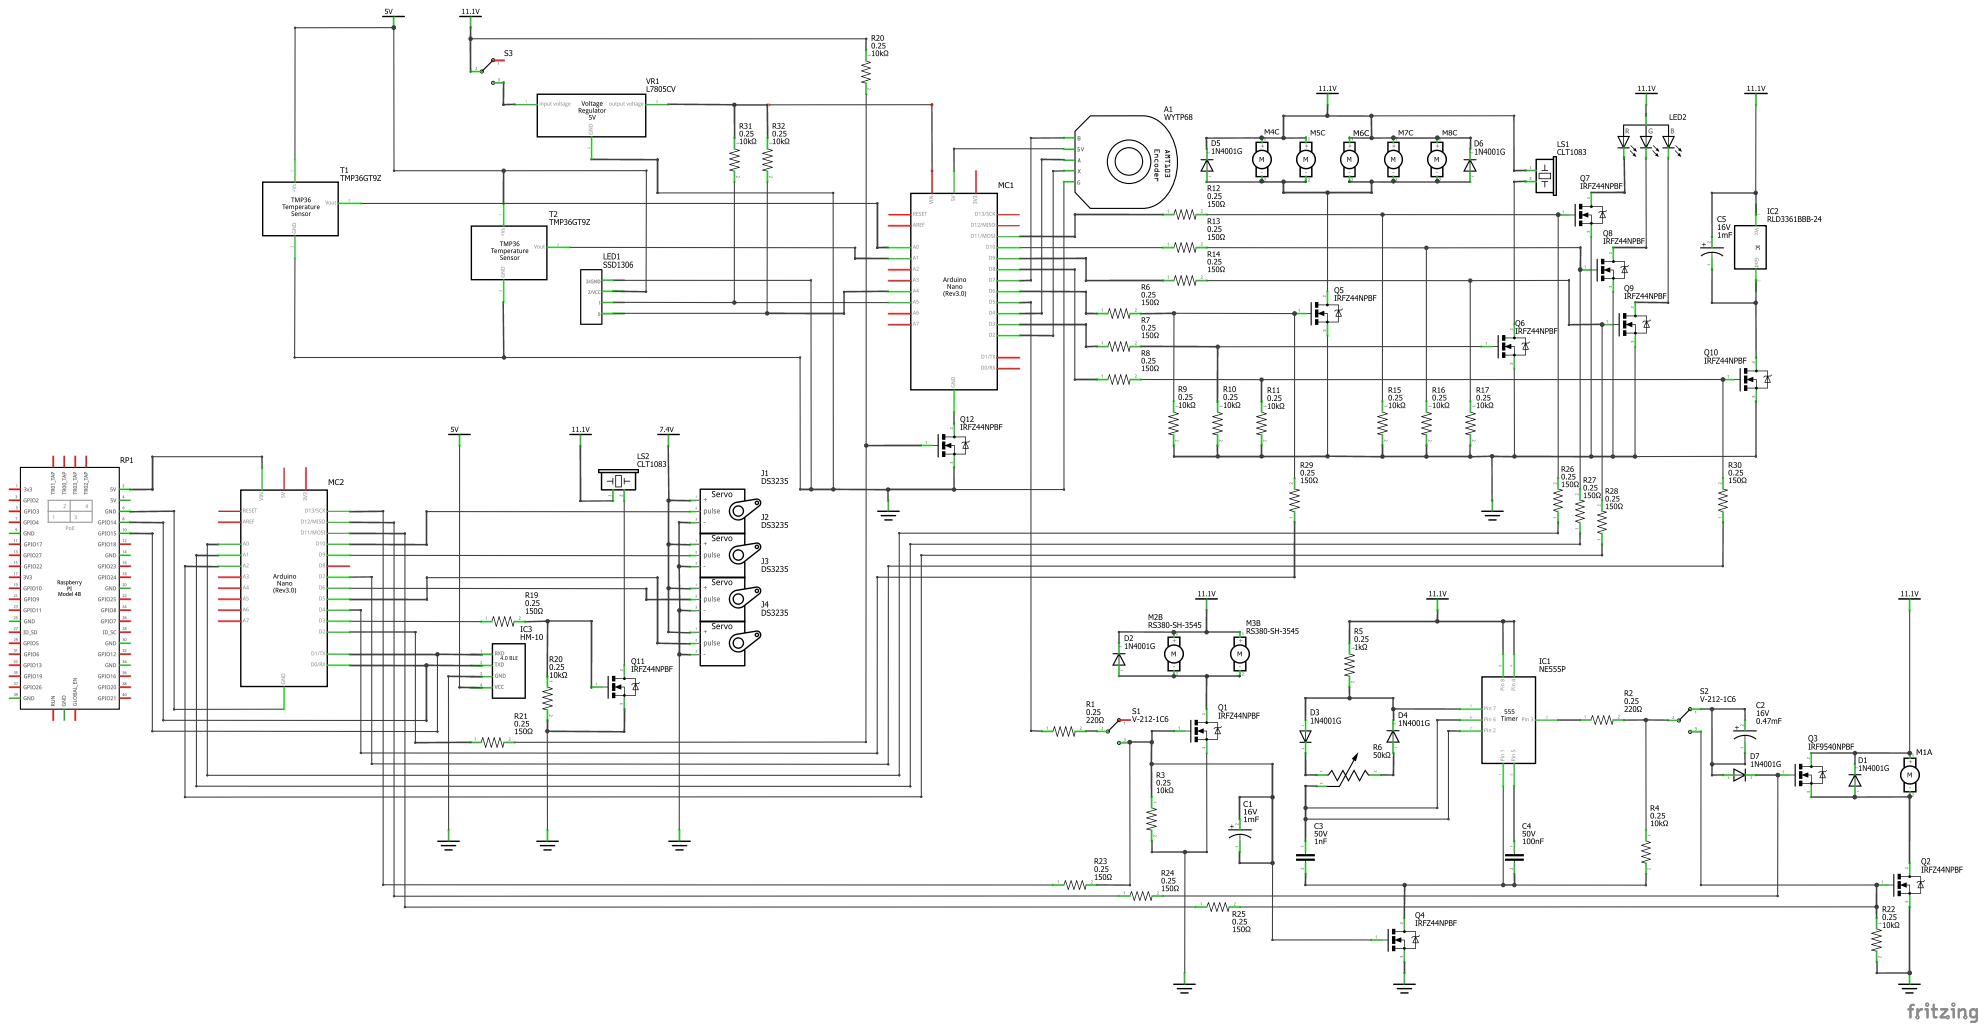
[picture p61: page 1]
