CasualCanadian/jareds/Schematics/J.A.R.E.D.S_Secondary-Circuit_schem.pdf

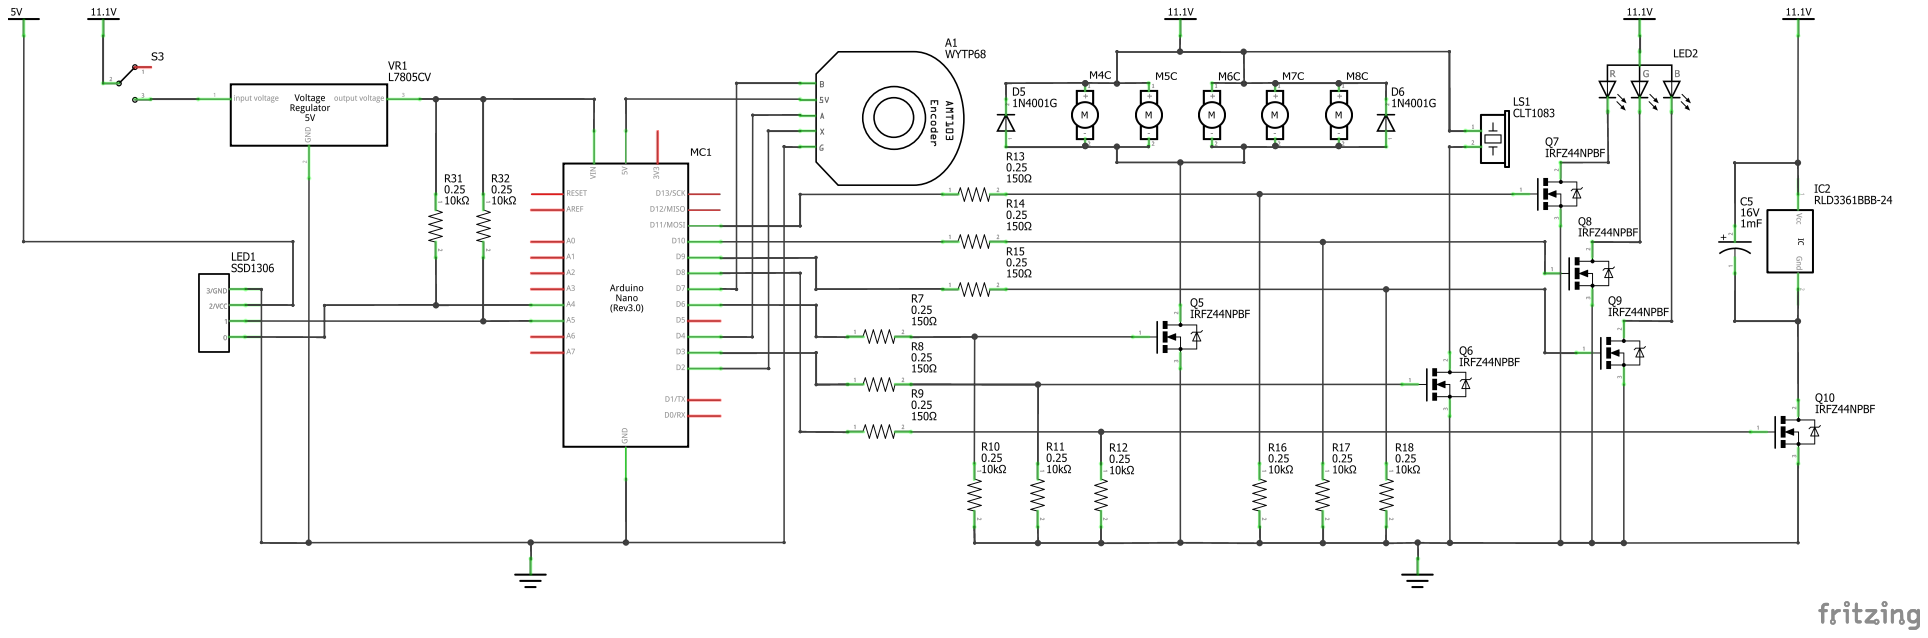
[picture p62: page 1]
